Skrooter/SmallLedPlatform/PCB/SmallLedPlatform.kicad_pcb

## KiCad design PCB/SmallLedPlatform.kicad_pcb (2023-04-14)

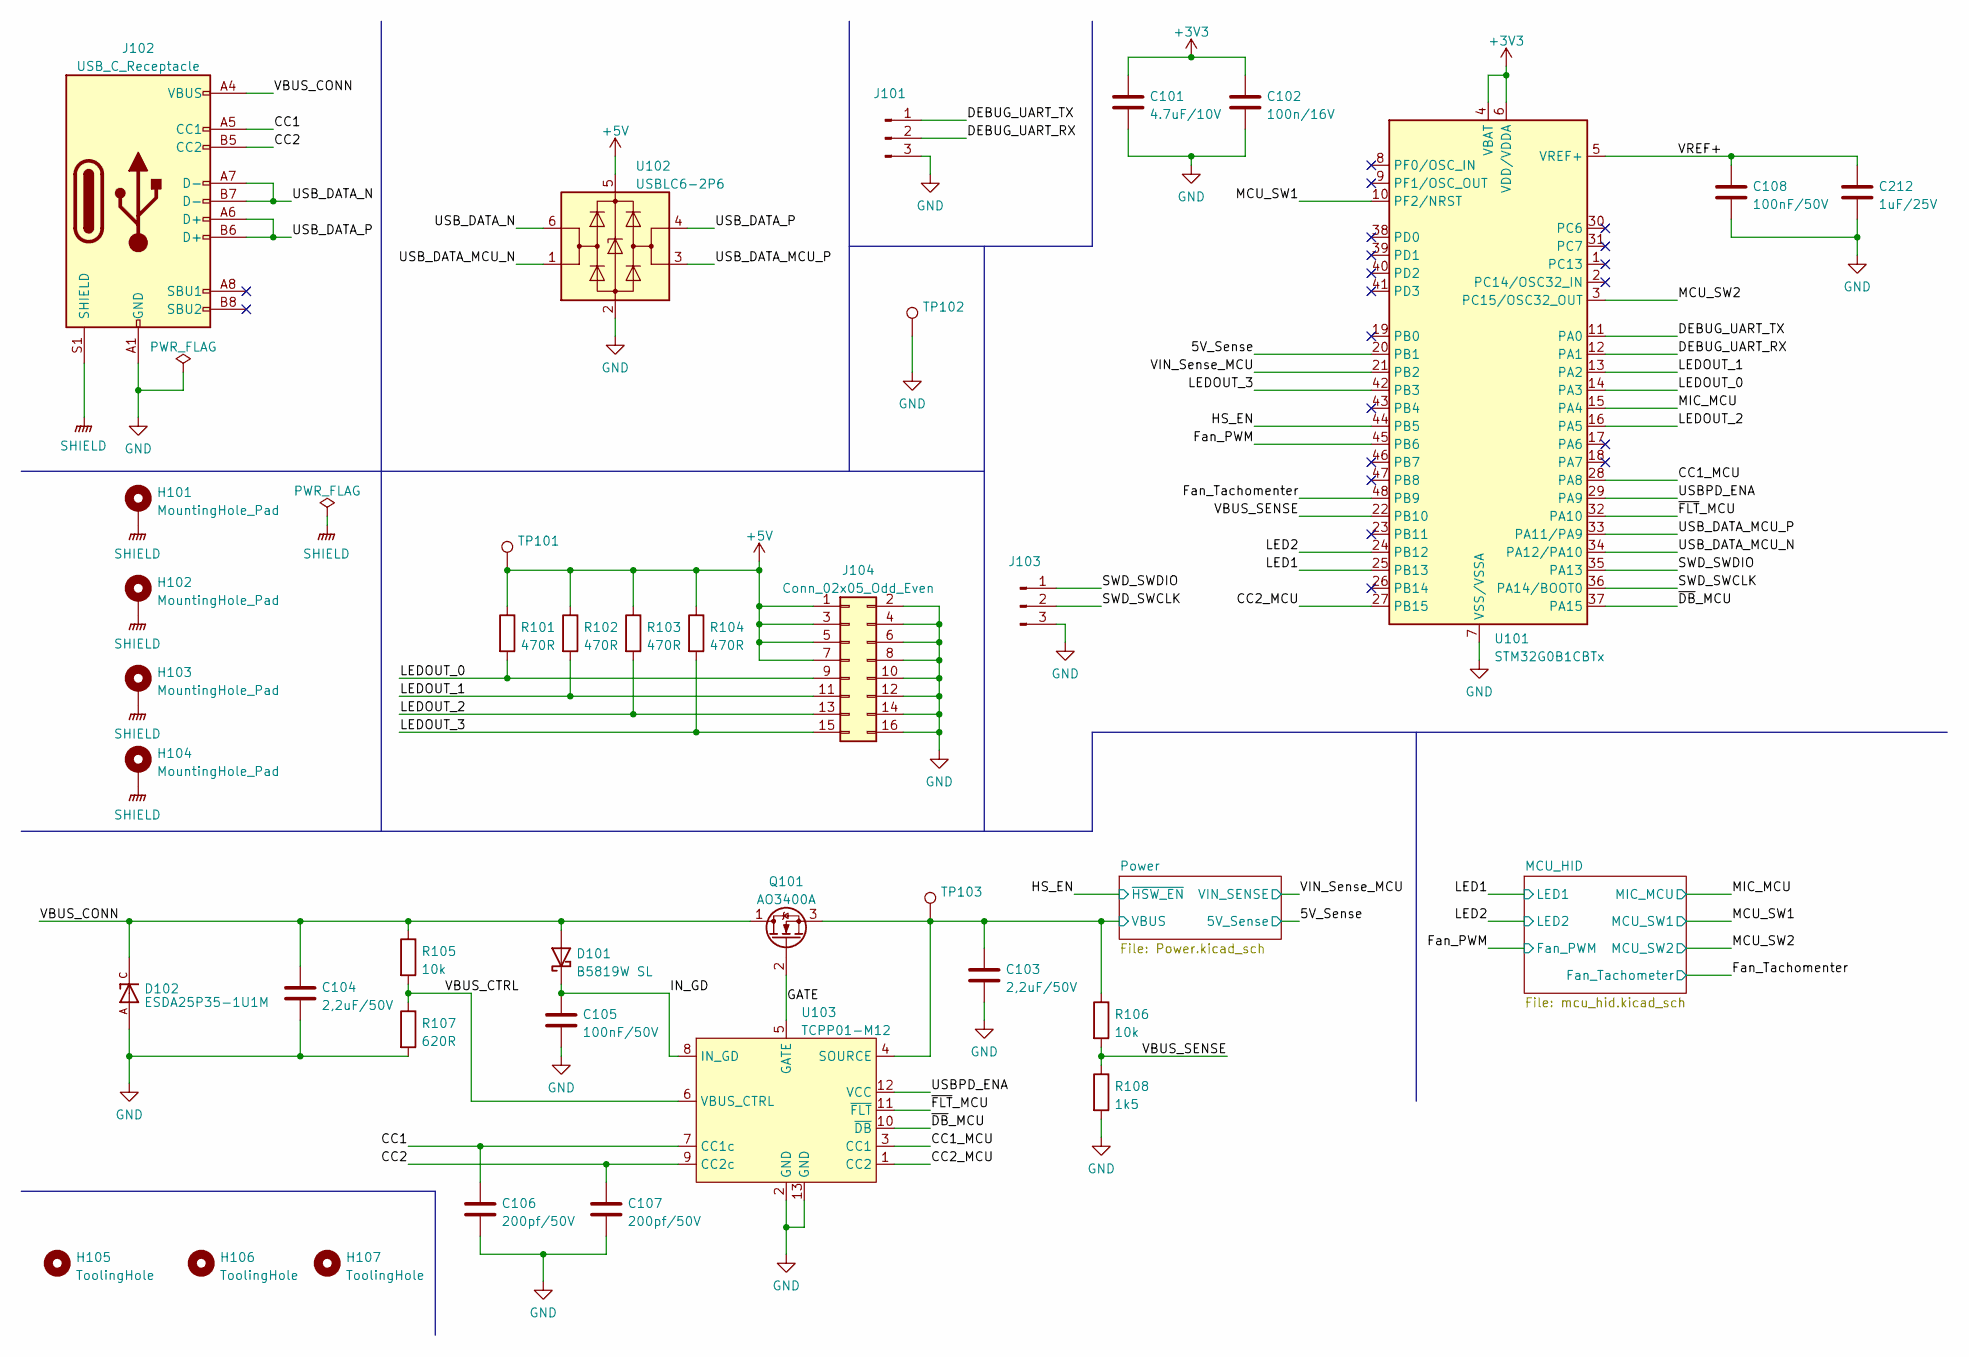
[picture p1: schematic SmallLedPlatform.kicad_sch]

Parts:
C101: 4.7uF/10V; C_0402_1005Metric; LCSC C23733
C102: 100n/16V; C_0402_1005Metric; LCSC C1525
C103, C104: 2,2uF/50V; C_0805_2012Metric; LCSC C49217
C105, C108: 100nF/50V; C_0402_1005Metric; LCSC C307331
C106, C107: 200pf/50V; C_0603_1608Metric; LCSC C1600
C212: 1uF/25V; C_0402_1005Metric; LCSC C52923
D101: B5819W SL; D_SOD-123; LCSC C8598
D102: ESDA25P35-1U1M; TVS_ESDA25P35-1U1M; PARTREV 2; LCSC C1974707
H101, H102, H103, H104: MountingHole_Pad; MountingHole_3.2mm_M3_Pad_Via
H105, H106, H107: ToolingHole; JLC_toolinghole
J101, J103: Conn_01x03_Male; PinHeader_1x03_P2.54mm_Vertical; LCSC C49257
J102: USB_C_Receptacle; USB_C_Receptacle_GCT_USB4105-xx-A_16P_TopMnt_Horizontal; LCSC C165948
J104: Conn_02x05_Odd_Even; PinHeader_2x08_P2.54mm_Horizontal; LCSC C68234
Q101: AO3400A; SOT-23; LCSC C20917
R101, R102, R103, R104: 470R; R_0402_1005Metric; LCSC C25117
R105, R106: 10k; R_0402_1005Metric; LCSC C25744
R107: 620R; R_0603_1608Metric; LCSC C23220
R108: 1k5; R_0402_1005Metric; LCSC C25867
TP101, TP102, TP103: TestPoint; TestPoint_Keystone_5000-5004_Miniature; LCSC C5199798
U101: STM32G0B1CBTx; LQFP-48_7x7mm_P0.5mm; LCSC C2847904
U102: USBLC6-2P6; SOT-666; LCSC C2827693
U103: TCPP01-M12; QFN-12-1EP_3x3mm_P0.5mm_EP1.6x1.6mm; LCSC C1121848

Connections:
+3V3: C101.1, C102.1, U101.4 (VBAT), U101.6 (VDD/VDDA); also elsewhere on the board
+5V: J104.1, J104.3, J104.5, J104.7, R101.1, R102.1, R103.1, R104.1, TP101.1, U102.5 (VBUS); also elsewhere on the board
/5V_Sense: U101.20 (PB1); also elsewhere on the board
/CC1: C106.1, J102.A5 (CC1), U103.7 (CC1c)
/CC1_MCU: U101.28 (PA8), U103.3 (CC1)
/CC2: C107.1, J102.B5 (CC2), U103.9 (CC2c)
/CC2_MCU: U101.27 (PB15), U103.1 (CC2)
/DEBUG_UART_RX: J101.2, U101.12 (PA1)
/DEBUG_UART_TX: J101.1, U101.11 (PA0)
/Fan_PWM: U101.45 (PB6); also elsewhere on the board
/Fan_Tachomenter: U101.48 (PB9); also elsewhere on the board
/GATE: Q101.2 (G), U103.5 (GATE)
/HS_EN: U101.44 (PB5); also elsewhere on the board
/IN_GD: C105.1, D101.1 (K), U103.8 (IN_GD)
/LED1: U101.25 (PB13); also elsewhere on the board
/LED2: U101.24 (PB12); also elsewhere on the board
/LEDOUT_0: J104.9, R101.2, U101.14 (PA3)
/LEDOUT_1: J104.11, R102.2, U101.13 (PA2)
/LEDOUT_2: J104.13, R103.2, U101.16 (PA5)
/LEDOUT_3: J104.15, R104.2, U101.42 (PB3)
/MCU_SW1: U101.10 (PF2/NRST); also elsewhere on the board
/MCU_SW2: U101.3 (PC15/OSC32_OUT); also elsewhere on the board
/MIC_MCU: U101.15 (PA4); also elsewhere on the board
/SWD_SWCLK: J103.2, U101.36 (PA14/BOOT0)
/SWD_SWDIO: J103.1, U101.35 (PA13)
/USBPD_ENA: U101.29 (PA9), U103.12 (VCC)
/USB_DATA_MCU_N: U101.34 (PA12/PA10), U102.1 (I/O1)
/USB_DATA_MCU_P: U101.33 (PA11/PA9), U102.3 (I/O2)
/USB_DATA_N: J102.A7 (D-), J102.B7 (D-), U102.6 (I/O1)
/USB_DATA_P: J102.A6 (D+), J102.B6 (D+), U102.4 (I/O2)
/VBUS_CONN: C104.1, D101.2 (A), D102.C, J102.A4 (VBUS), J102.A9 (VBUS), J102.B4 (VBUS), J102.B9 (VBUS), Q101.1 (D), R105.1
/VBUS_CTRL: R105.2, R107.1, U103.6 (VBUS_CTRL)
/VBUS_SENSE: R106.2, R108.1, U101.22 (PB10)
/VIN_Sense_MCU: U101.21 (PB2); also elsewhere on the board
/~DB_MCU: U101.37 (PA15), U103.10 (~DB)
/~FLT_MCU: U101.32 (PA10), U103.11 (~FLT)
GND: C101.2, C102.2, C103.2, C104.2, C105.2, C106.2, C107.2, C108.2, C212.2, D102.A, J101.3, J102.A1 (GND), J102.A12 (GND), J102.B1 (GND), J102.B12 (GND), J103.3, J104.2, J104.4, J104.6, J104.8, J104.10, J104.12, J104.14, J104.16, R107.2, R108.2, TP102.1, U101.7 (VSS/VSSA), U102.2 (GND), U103.2 (GND), U103.13 (GND); also elsewhere on the board
IN: C103.1, Q101.3 (S), R106.1, TP103.1, U103.4 (SOURCE); also elsewhere on the board
SHIELD: H101.1, H102.1, H103.1, H104.1, J102.S1 (SHIELD)

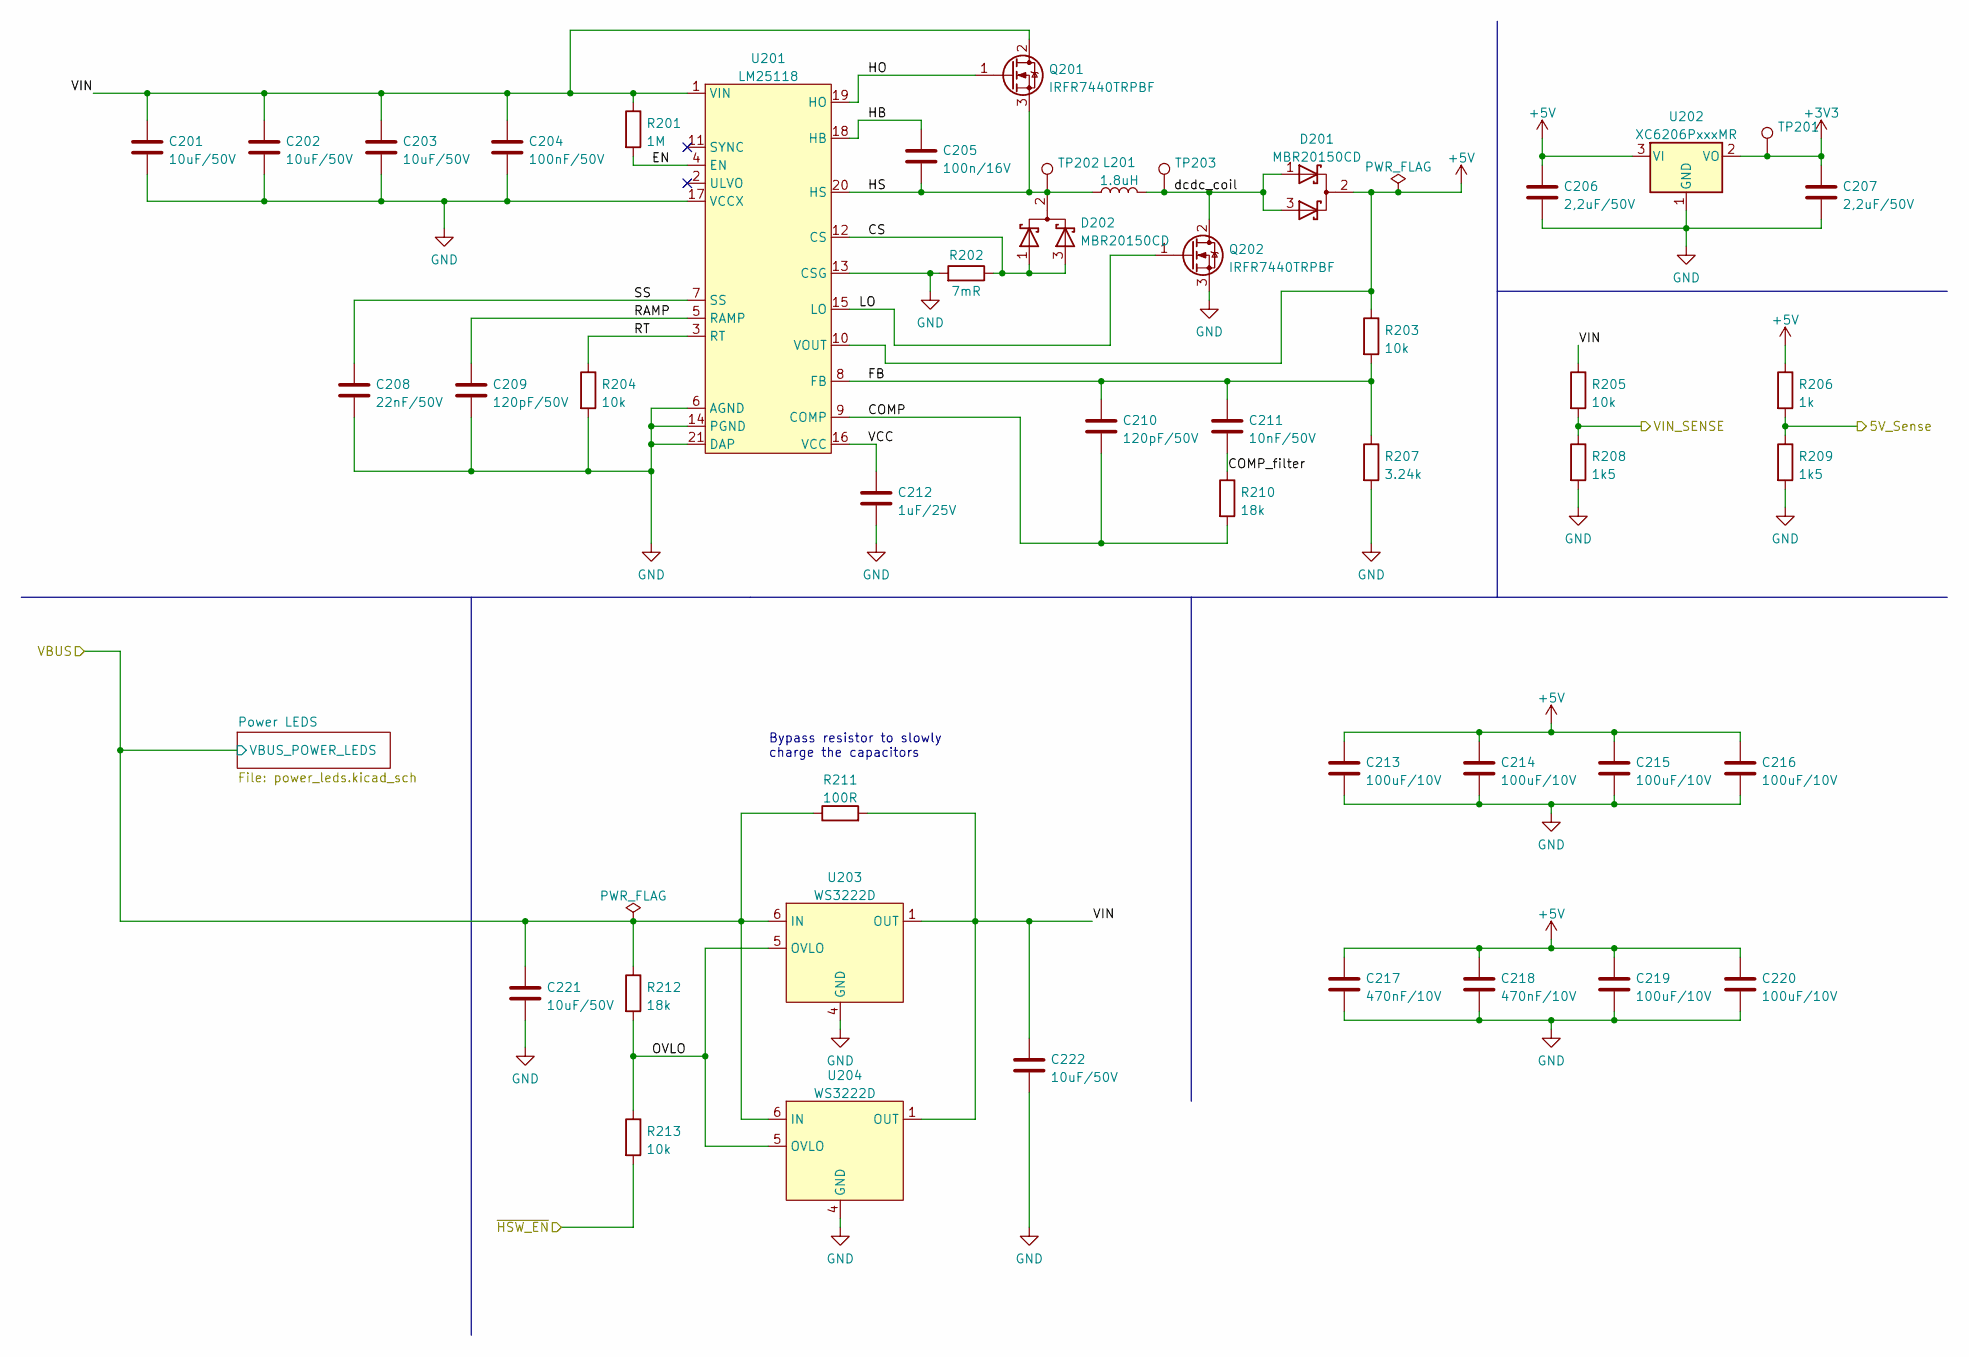
[picture p2: schematic Power.kicad_sch]

Parts:
C201, C202, C203, C221, C222: 10uF/50V; C_0805_2012Metric; LCSC C440198
C204: 100nF/50V; C_0402_1005Metric; LCSC C307331
C205: 100n/16V; C_0402_1005Metric; LCSC C1525
C206, C207: 2,2uF/50V; C_0805_2012Metric; LCSC C49217
C208: 22nF/50V; C_0402_1005Metric; LCSC C1532
C209, C210: 120pF/50V; C_0402_1005Metric; LCSC C312114
C211: 10nF/50V; C_0402_1005Metric; LCSC C15195
C212: 1uF/25V; C_0402_1005Metric; LCSC C52923
C213, C214, C215, C216, C219, C220: 100uF/10V; C_1206_3216Metric; LCSC C312983
C217, C218: 470nF/10V; C_0402_1005Metric; LCSC C47339
D201, D202: MBR20150CD; TO-252-2; LCSC C698783
L201: 1.8uH; L_12x12mm_H8mm; LCSC C718301
Q201, Q202: IRFR7440TRPBF; TO-252-2; LCSC C97244
R201: 1M; R_0402_1005Metric; LCSC C26083
R202: 7mR; R_2512_6332Metric; LCSC C728341
R203, R204, R205, R213: 10k; R_0402_1005Metric; LCSC C25744
R206: 1k; R_0402_1005Metric; LCSC C11702
R207: 3.24k; R_0402_1005Metric; LCSC C25890
R208, R209: 1k5; R_0402_1005Metric; LCSC C25867
R210, R212: 18k; R_0402_1005Metric; LCSC C25762
R211: 100R; R_1206_3216Metric; LCSC C17901
TP201, TP202, TP203: TestPoint; TestPoint_Keystone_5000-5004_Miniature; LCSC C5199798
U201: LM25118; HTSSOP-20-1EP_4.4x6.5mm_P0.65mm_EP3.4x6.5mm_Mask2.75x3.43mm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; LCSC C470962
U202: XC6206PxxxMR; SOT-23-3; LCSC C5446
U203, U204: WS3222D; WDFN-8-1EP_2x2mm_P0.5mm_EP0.8x1.2mm; LCSC C239703

Connections:
+3V3: C207.1, TP201.1, U202.2 (VO); also elsewhere on the board
+5V: C206.1, C213.1, C214.1, C215.1, C216.1, C217.1, C218.1, C219.1, C220.1, D201.2 (A), R203.1, R206.1, U201.10 (VOUT), U202.3 (VI); also elsewhere on the board
/5V_Sense: R206.2, R209.1; also elsewhere on the board
/HS_EN: R213.2; also elsewhere on the board
/Power/COMP: C210.2, R210.2, U201.9 (COMP)
/Power/COMP_filter: C211.2, R210.1
/Power/CS: D202.1 (K), D202.3 (K), R202.1, U201.12 (CS)
/Power/EN: R201.2, U201.4 (EN)
/Power/FB: C210.1, C211.1, R203.2, R207.1, U201.8 (FB)
/Power/HB: C205.1, U201.18 (HB)
/Power/HO: Q201.1 (G), U201.19 (HO)
/Power/HS: C205.2, D202.2 (A), L201.1, Q201.3 (S), TP202.1, U201.20 (HS)
/Power/LO: Q202.1 (G), U201.15 (LO)
/Power/OVLO: R212.2, R213.1, U203.5 (OVLO), U204.5 (OVLO)
/Power/RAMP: C209.1, U201.5 (RAMP)
/Power/RT: R204.1, U201.3 (RT)
/Power/SS: C208.1, U201.7 (SS)
/Power/VIN: C201.1, C202.1, C203.1, C204.1, C222.1, Q201.2 (D), R201.1, R205.1, R211.2, U201.1 (VIN), U203.1 (OUT), U203.2 (OUT), U203.3 (OUT), U204.1 (OUT), U204.2 (OUT), U204.3 (OUT)
/Power/dcdc_coil: D201.1 (K), D201.3 (K), L201.2, Q202.2 (D), TP203.1
/VIN_Sense_MCU: R205.2, R208.1; also elsewhere on the board
GND: C201.2, C202.2, C203.2, C204.2, C206.2, C207.2, C208.2, C209.2, C212.2, C213.2, C214.2, C215.2, C216.2, C217.2, C218.2, C219.2, C220.2, C221.2, C222.2, Q202.3 (S), R202.2, R204.2, R207.2, R208.2, R209.2, U201.6 (AGND), U201.13 (CSG), U201.14 (PGND), U201.17 (VCCX), U201.21 (DAP), U202.1 (GND), U203.4 (GND), U203.9 (GND), U204.4 (GND), U204.9 (GND); also elsewhere on the board
IN: C221.1, R211.1, R212.1, U203.6 (IN), U203.7 (IN), U203.8 (IN), U204.6 (IN), U204.7 (IN), U204.8 (IN); also elsewhere on the board

Notes on the sheet:
Bypass resistor to slowly charge the capacitors

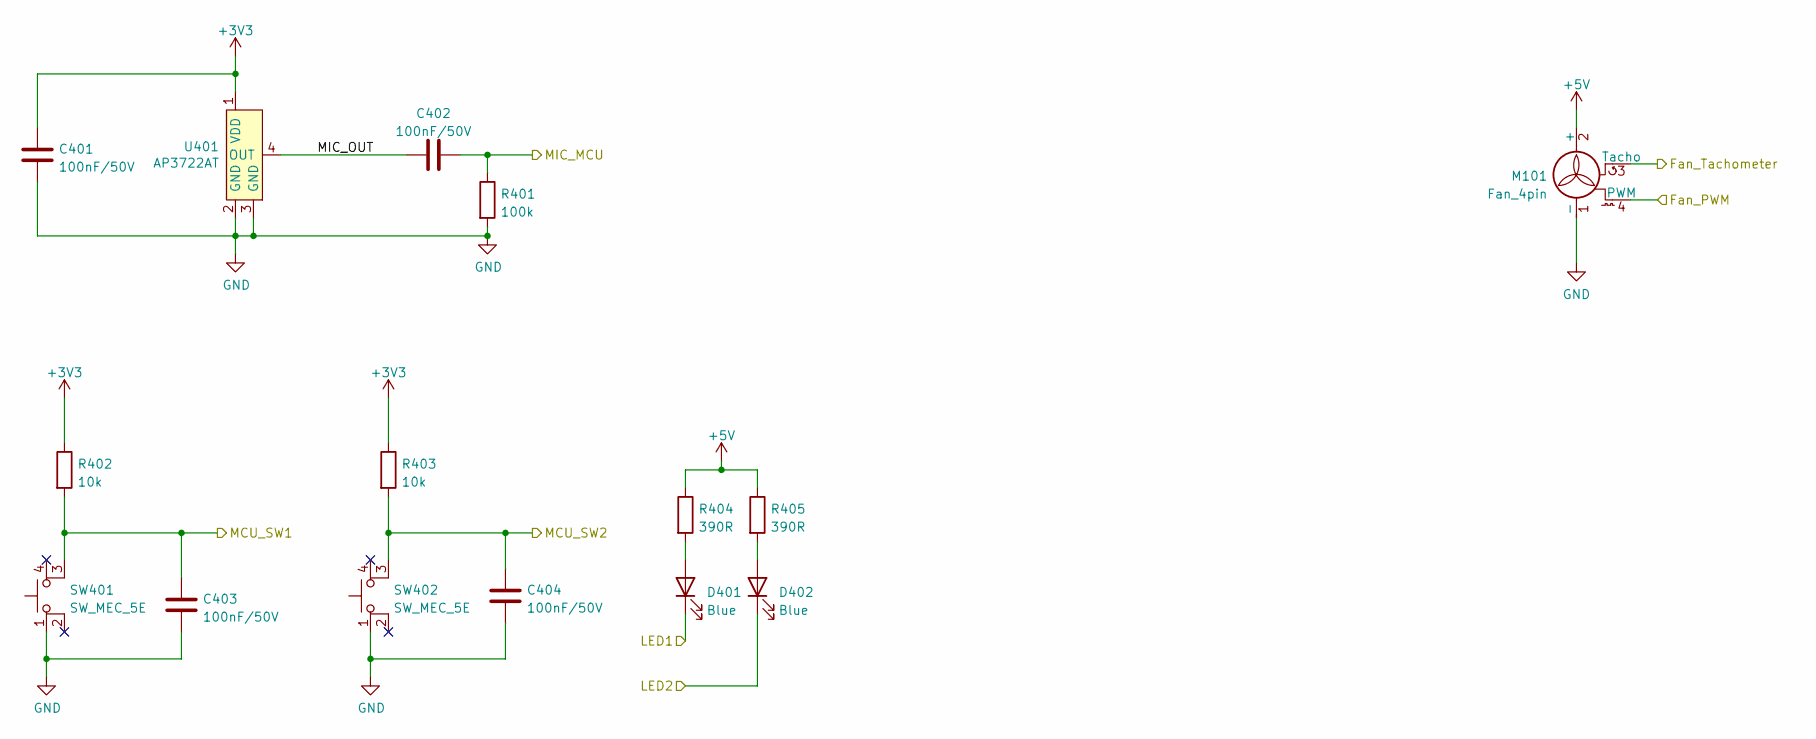
[picture p3: schematic mcu_hid.kicad_sch]

Parts:
C401, C402, C403, C404: 100nF/50V; C_0402_1005Metric; LCSC C307331
D401, D402: Blue; LED_0603_1608Metric; LCSC C72041
M101: Fan_4pin; PinHeader_1x04_P2.54mm_Vertical_SMD_Pin1Left
R401: 100k; R_0402_1005Metric; LCSC C25741
R402, R403: 10k; R_0402_1005Metric; LCSC C25744
R404, R405: 390R; R_0603_1608Metric; LCSC C23151
SW401, SW402: SW_MEC_5E; SW_MEC_5GSH9
U401: AP3722AT; LCSC C918198

Connections:
+3V3: C401.1, R402.1, R403.1, U401.1 (VDD); also elsewhere on the board
+5V: R404.1, R405.1; also elsewhere on the board
/LED1: D401.1 (K); also elsewhere on the board
/LED2: D402.1 (K); also elsewhere on the board
/MCU_HID/MIC_OUT: C402.1, U401.4 (OUT)
/MCU_SW1: C403.1, R402.2, SW401.3 (K); also elsewhere on the board
/MCU_SW2: C404.1, R403.2, SW402.3 (K); also elsewhere on the board
/MIC_MCU: C402.2, R401.1; also elsewhere on the board
GND: C401.2, C403.2, C404.2, R401.2, SW401.1, SW402.1, U401.2 (GND), U401.3 (GND); also elsewhere on the board
unnamed: D401.2 (A), R404.2
unnamed: D402.2 (A), R405.2

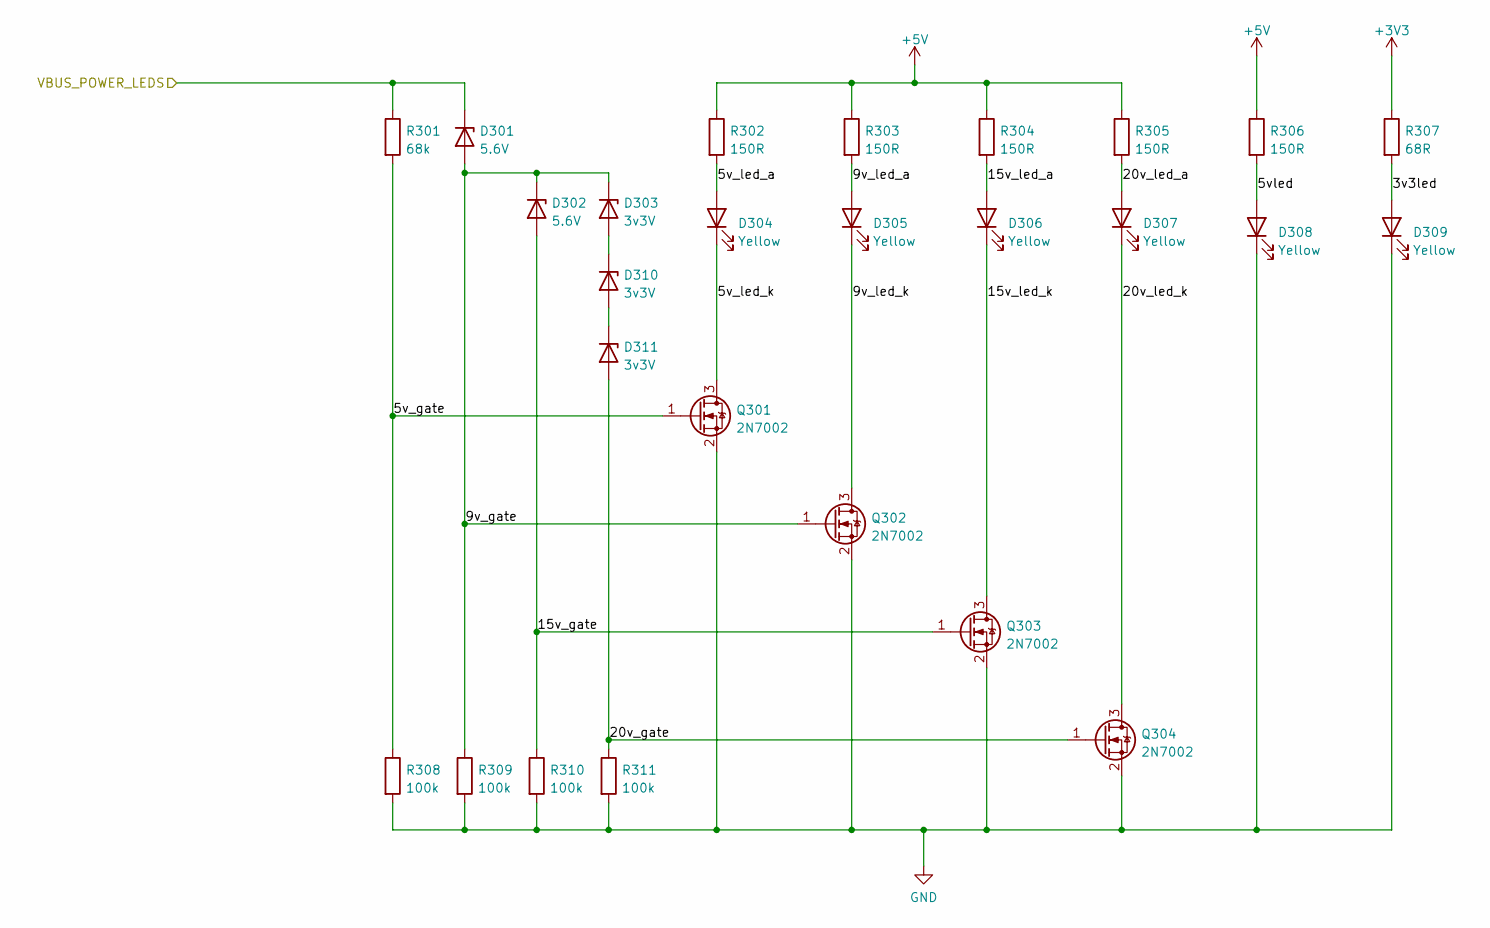
[picture p4: schematic power_leds.kicad_sch]

Parts:
D301, D302: 5.6V; D_MiniMELF; LCSC C8062
D303, D310, D311: 3v3V; D_MiniMELF; LCSC C8056
D304, D305, D306, D307, D308, D309: Yellow; LED_0603_1608Metric_smaller_silk; LCSC C72038
Q301, Q302, Q303, Q304: 2N7002; SOT-23; LCSC C8545
R301: 68k; R_0402_1005Metric; LCSC C36871
R302, R303, R304, R305, R306: 150R; R_0402_1005Metric; LCSC C25082
R307: 68R; R_0603_1608Metric; LCSC C27592
R308, R309, R310, R311: 100k; R_0402_1005Metric; LCSC C25741

Connections:
+3V3: R307.1; also elsewhere on the board
+5V: R302.1, R303.1, R304.1, R305.1, R306.1; also elsewhere on the board
/Power/Power LEDS/3v3led: D309.2 (A), R307.2
/Power/Power LEDS/5v_gate: Q301.1 (G), R301.2, R308.1
/Power/Power LEDS/5v_led_a: D304.2 (A), R302.2
/Power/Power LEDS/5v_led_k: D304.1 (K), Q301.3 (D)
/Power/Power LEDS/5vled: D308.2 (A), R306.2
/Power/Power LEDS/9v_gate: D301.2 (A), D302.1 (K), D303.1 (K), Q302.1 (G), R309.1
/Power/Power LEDS/9v_led_a: D305.2 (A), R303.2
/Power/Power LEDS/9v_led_k: D305.1 (K), Q302.3 (D)
/Power/Power LEDS/15v_gate: D302.2 (A), Q303.1 (G), R310.1
/Power/Power LEDS/15v_led_a: D306.2 (A), R304.2
/Power/Power LEDS/15v_led_k: D306.1 (K), Q303.3 (D)
/Power/Power LEDS/20v_gate: D311.2 (A), Q304.1 (G), R311.1
/Power/Power LEDS/20v_led_a: D307.2 (A), R305.2
/Power/Power LEDS/20v_led_k: D307.1 (K), Q304.3 (D)
GND: D308.1 (K), D309.1 (K), Q301.2 (S), Q302.2 (S), Q303.2 (S), Q304.2 (S), R308.2, R309.2, R310.2, R311.2; also elsewhere on the board
IN: D301.1 (K), R301.1; also elsewhere on the board
unnamed: D303.2 (A), D310.1 (K)
unnamed: D310.2 (A), D311.1 (K)

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
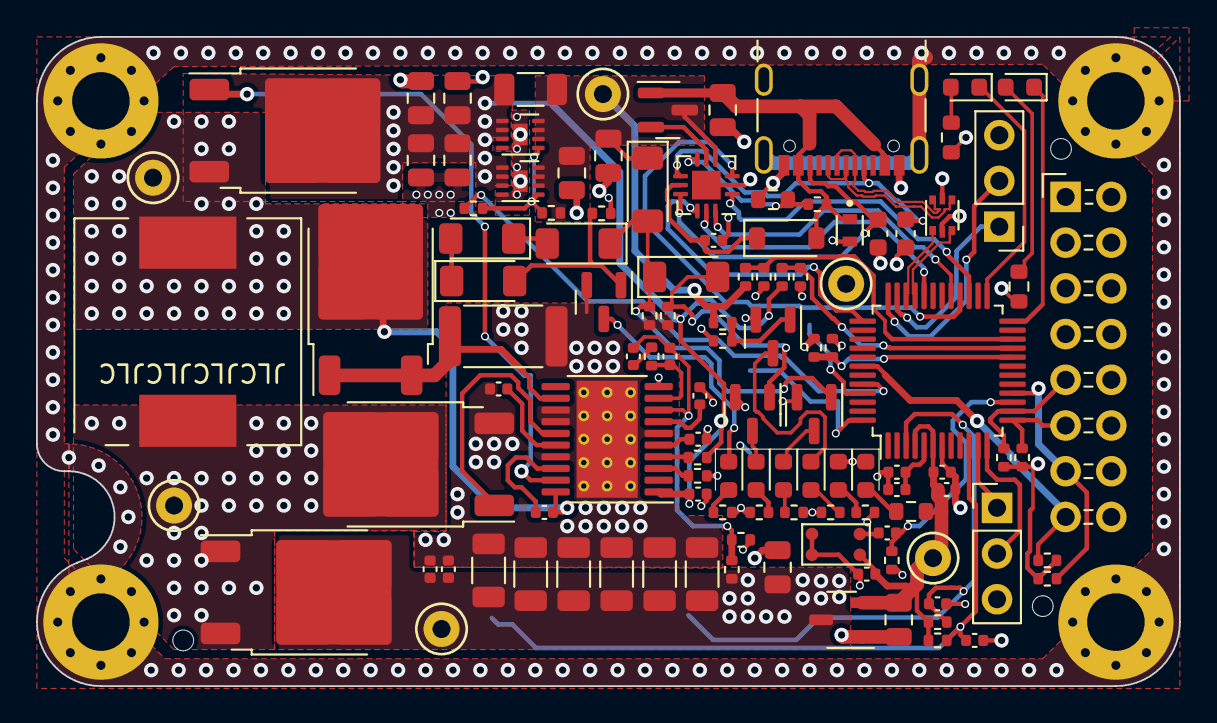
[picture p5: board SmallLedPlatform.kicad_pcb from above]

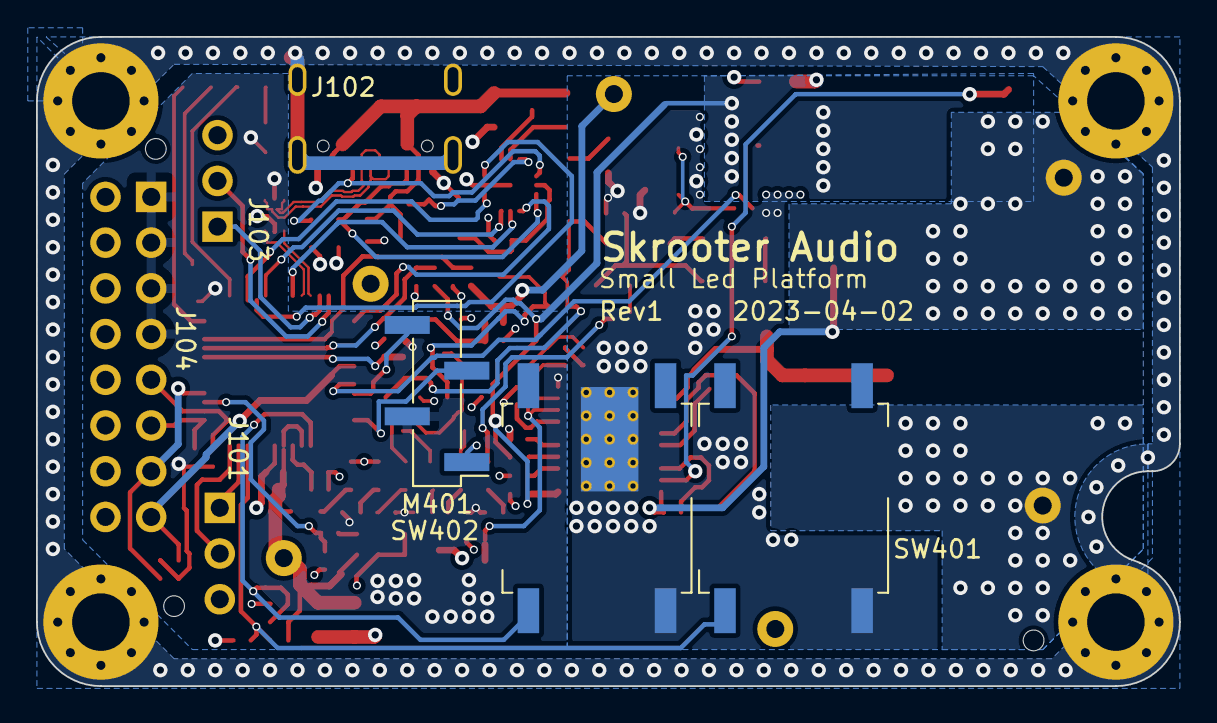
[picture p6: board SmallLedPlatform.kicad_pcb from below]

Board: 4 copper layers, 63.5 x 36.1 mm, 125 parts (3 on the bottom side), 75 nets.

Other parts of the board:
C109: 1uF/25V; C_0402_1005Metric
M401: Fan_4pin; PinHeader_1x04_P2.54mm_Vertical_SMD_Pin1Left

Their connections:
+5V: M401.2 (+); also elsewhere on the board
/Fan_PWM: M401.4 (PWM); also elsewhere on the board
/Fan_Tachomenter: M401.3 (Tacho); also elsewhere on the board
GND: C109.2, M401.1 (-); also elsewhere on the board
