Skrooter/SmallLedPlatform/Cube/SmallLedPlatform.ioc

Mcu.UserName=STM32G0B1CBTx
PA0.Signal=USART4_TX
PA1.Signal=USART4_RX
PA10.GPIO_Label=FLT_MCU
PA10.Signal=GPIO_Output
PA13.Signal=SYS_SWDIO
PA14-BOOT0.Signal=SYS_SWCLK
PA15.GPIO_Label=DB_MCU
PA15.Signal=GPIO_Output
PA2.GPIO_Label=LEDOUT_1
PA2.Signal=S_TIM2_CH3
PA3.GPIO_Label=LEDOUT_0
PA3.Signal=S_TIM2_CH4
PA4.GPIO_Label=MICIN
PA4.Signal=ADC1_IN4
PA5.GPIO_Label=LEDOUT_2
PA5.Signal=S_TIM2_CH1_ETR
PA6.GPIO_Label=sense_vbus
PA6.Signal=ADC1_IN6
PA8.Signal=UCPD1_CC1
PA9.GPIO_Label=USBPD_ENA
PA9.Signal=GPIO_Output
PB1.GPIO_Label=sense_5v
PB1.Signal=ADC1_IN9
PB10.GPIO_Label=sense_vbus
PB10.Signal=ADC1_IN11
PB12.GPIO_Label=MCU_LED2
PB12.Signal=GPIO_Output
PB13.GPIO_Label=MCU_LED1
PB13.Signal=GPIO_Output
PB15.Signal=UCPD1_CC2
PB2.GPIO_Label=sense_vin
PB2.Signal=ADC1_IN10
PB3.GPIO_Label=LEDOUT_3
PB3.Signal=S_TIM2_CH2
PB5.GPIO_Label=HS_EN
PB5.Signal=GPIO_Output
PB6.GPIO_Label=FAN_PWM
PB6.Signal=S_TIM4_CH1
PB9.GPIO_Label=FAN_TACH
PB9.Signal=S_TIM4_CH4
PF2-NRST.GPIO_Label=sw1
PF2-NRST.Signal=GPIO_Input
