Skrooter/SmallLedPlatform/(commit log)

2023-01-16 Add a new DC/DC solution to the schematic
    Components has been added to layout, but not properly done
    [Power.kicad_sch, SmallLedPlatform.kicad_pcb, smallLEDplatform.kicad_sch]
2023-01-21 reroute pretty much everything
    Routing is done for new DC/DC!
    [Power.kicad_sch, SmallLedPlatform.kicad_pcb, SmallLedPlatform.kicad_sch, mcu_hid.kicad_sch, power_leds.kicad_sch]
2023-01-23 Add LEDs for each USBPD level and a microphone
    [Power.kicad_sch, SmallLedPlatform.kicad_pcb, SmallLedPlatform.kicad_sch, mcu_hid.kicad_sch, power_leds.kicad_sch]
2023-02-07 Prepare board for manufactoring
    [SmallLedPlatform.kicad_pcb]
2023-02-07 Add fan header on backside of board
    [Power.kicad_sch, SmallLedPlatform.kicad_pcb, SmallLedPlatform.kicad_sch, mcu_hid.kicad_sch]
2023-02-10 Added hole for fan cable entry
    [SmallLedPlatform.kicad_pcb]
2023-02-10 Fix DRC and outline
    [SmallLedPlatform.kicad_pcb]
2023-02-11 Add production text to PCB
    [SmallLedPlatform.kicad_pcb]
2023-03-01 Remove duplicate file
    [smallLEDplatform.kicad_sch]
2023-03-11 Fix review comments
    [Power.kicad_sch, SmallLedPlatform.kicad_pcb, SmallLedPlatform.kicad_sch, mcu_hid.kicad_sch, power_leds.kicad_sch]
2023-04-14 Final fixes before production
    [Power.kicad_sch, SmallLedPlatform.kicad_pcb, SmallLedPlatform.kicad_sch, mcu_hid.kicad_sch]
